janelia-modular-devices/led_controller/README.org

#+TITLE: led_controller
#+AUTHOR: Peter Polidoro
#+EMAIL: peter@polidoro.io

* Repository Information
  - Author :: Peter Polidoro
  - License :: BSD
