janelia-modular-devices/led_controller/hardware/schematic/led_controller.pdf

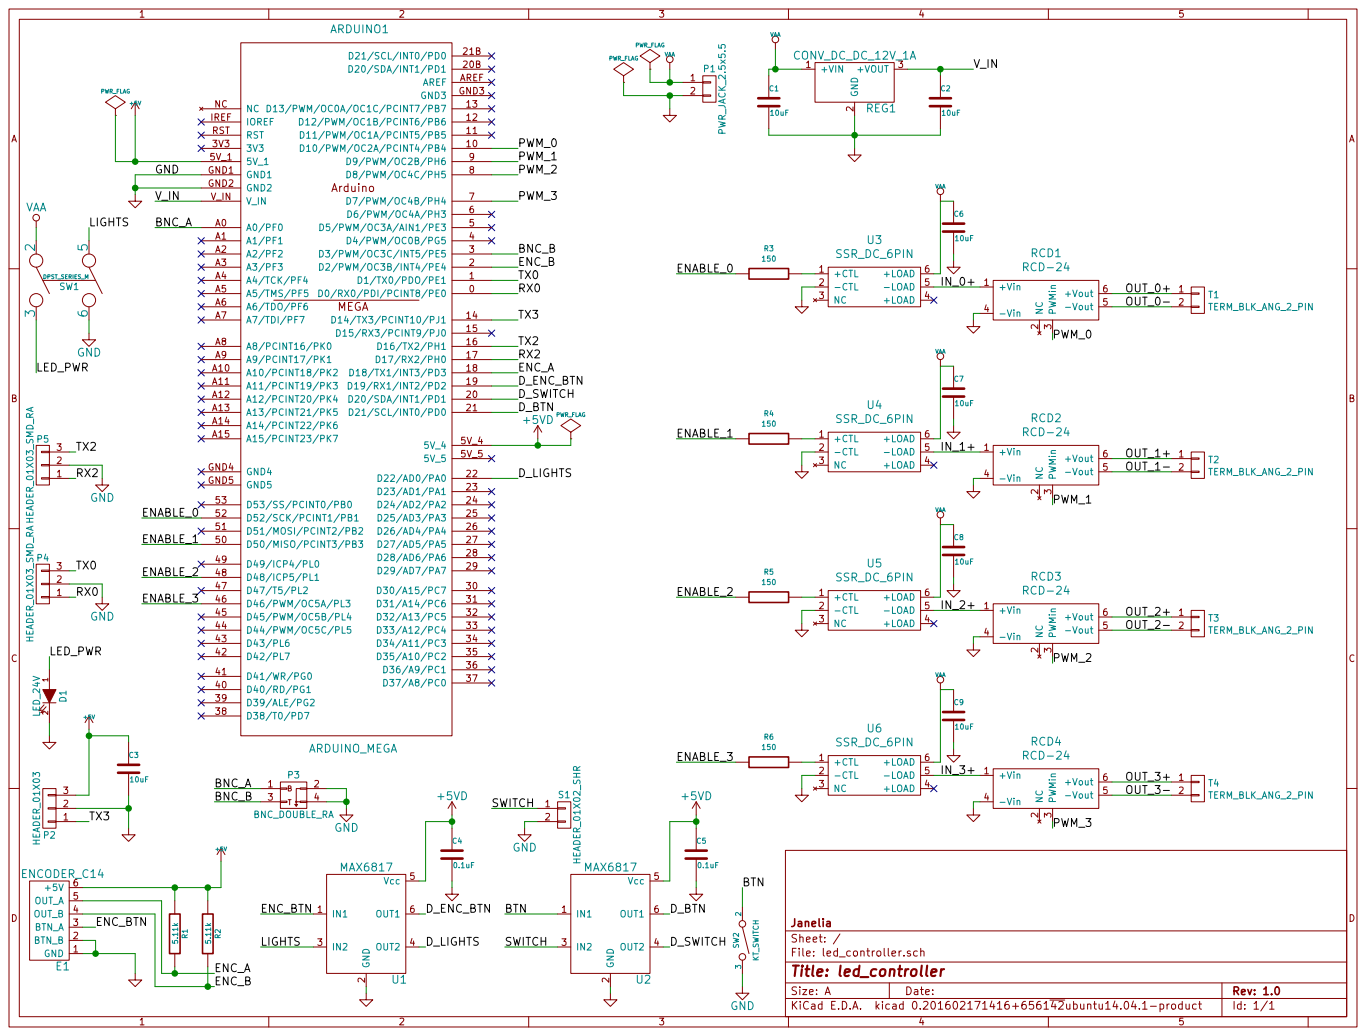
[picture p1: page 1]

File: led_controller.sch Sheet: / Janelia
