janelia-modular-devices/led_controller/(list of files, drawings)

Other design files:
hardware/led_controller.dsn
