janelia-modular-devices/led_controller/firmware/Constants.h

// ----------------------------------------------------------------------------
// Constants.h
//
//
// Authors:
// Peter Polidoro peter@polidoro.io
// ----------------------------------------------------------------------------
#ifndef CONSTANTS_H
#define CONSTANTS_H
#include "ConstantVariable.h"
#include "StandaloneInterface.h"


namespace constants
{
//MAX values must be >= 1, >= created/copied count, < RAM limit
enum{SAVED_VARIABLE_COUNT_MAX=4};
enum{PARAMETER_COUNT_MAX=16};
enum{METHOD_COUNT_MAX=20};

enum{DISPLAY_LABEL_COUNT_MAX=10};
enum{DISPLAY_VARIABLE_COUNT_MAX=1};
enum{INTERACTIVE_VARIABLE_COUNT_MAX=10};
enum {FRAME_COUNT=7};

enum {CHANNEL_COUNT=4};
enum {INDEXED_CHANNELS_POWER_COUNT_MAX=4};
enum {INDEXED_PULSES_COUNT_MAX=4};

extern const unsigned int baudrate;

extern const unsigned int model_number;

extern const unsigned char firmware_major;
extern const unsigned char firmware_minor;
extern const unsigned char firmware_patch;

extern const Standalone::Configuration standalone_configuration;

extern const int pwm_pins[CHANNEL_COUNT];
extern const int enable_pins[CHANNEL_COUNT];

extern const uint8_t power_min;
extern const uint8_t power_max;

extern const int analog_out_min;
extern const int analog_out_max;

extern const uint32_t duration_min;
extern const uint32_t duration_max;

extern const float frequency_min;
extern const float frequency_max;

extern const uint8_t duty_cycle_min;
extern const uint8_t duty_cycle_max;

extern const int delay;

extern const uint8_t dsp_lbl_display_position;
extern const uint8_t int_var_display_position;

extern const uint8_t dsp_lbl_display_position_2;
extern const uint8_t int_var_display_position_2;

extern const uint8_t inc_dsp_lbl_display_position;
extern const uint8_t inc_int_var_display_position;
extern const uint8_t chnl_dsp_lbl_display_position;
extern const uint8_t chnl_int_var_display_position;
extern const uint8_t pwr_dsp_lbl_display_position;
extern const uint8_t pwr_int_var_display_position;

extern const uint8_t period_dsp_lbl_display_position;
extern const uint8_t on_dsp_lbl_display_position;
extern const uint8_t count_dsp_lbl_display_position;

extern const uint8_t period_int_var_display_position;
extern const uint8_t on_int_var_display_position;
extern const uint8_t count_int_var_display_position;

extern const int inc_width_max;
extern const long display_period_min;
extern const long display_period_max;
extern const long display_period_default;
extern const long display_on_min;
extern const long display_on_max;
extern const long display_on_default;
extern const long display_count_min;
extern const long display_count_max;
extern const long display_count_default;
extern const long display_power_default;

extern ConstantString inc_dsp_lbl_str;
extern ConstantString chnl_dsp_lbl_str;
extern ConstantString pwr_dsp_lbl_str;

extern ConstantString period_dsp_lbl_str;
extern ConstantString on_dsp_lbl_str;
extern ConstantString count_dsp_lbl_str;

extern ConstantString device_name;

extern ConstantString duration_units_name;
extern ConstantString frequency_units_name;
extern ConstantString duty_cycle_units_name;
extern ConstantString power_units_name;

extern ConstantString channels_parameter_name;
extern ConstantString channel_parameter_name;
extern ConstantString power_parameter_name;
extern ConstantString powers_parameter_name;
extern ConstantString state_parameter_name;
extern ConstantString on_duration_parameter_name;
extern ConstantString period_parameter_name;
extern ConstantString count_parameter_name;
extern ConstantString frequency_parameter_name;
extern ConstantString duty_cycle_parameter_name;
extern ConstantString pwm_duration_parameter_name;
extern ConstantString pulse_wave_index_parameter_name;

extern ConstantString set_channel_power_method_name;
extern ConstantString set_channel_off_method_name;
extern ConstantString set_channels_powers_method_name;
extern ConstantString set_channels_off_method_name;
extern ConstantString set_all_channels_power_method_name;
extern ConstantString set_all_channels_off_method_name;
extern ConstantString get_channels_powers_method_name;
extern ConstantString get_channel_count_method_name;
extern ConstantString add_pwm_period_on_duration_method_name;
extern ConstantString add_pwm_frequency_duty_cycle_method_name;
extern ConstantString stop_all_pulses_method_name;
extern ConstantString start_pwm_period_on_duration_method_name;
extern ConstantString start_pwm_frequency_duty_cycle_method_name;
extern ConstantString stop_pulse_wave_method_name;

extern ConstantString pwm_method_name;
extern ConstantString set_pwm_defaults_method_name;
extern const ConstantString frame_name_array[FRAME_COUNT];
}
#endif
