janelia-modular-devices/led_controller/(commit log)

2016-01-29 Initial commit.
    [led_controller.dsn, led_controller.kicad_pcb, led_controller.sch]
2016-01-29 Base led_controller off aalborg_mfc_interface pcb.
    [led_controller.dsn, led_controller.kicad_pcb, led_controller.sch]
2016-01-29 Added some components.
    [led_controller.sch]
2016-02-02 Intermediate changes.
    [led_controller.sch]
2016-02-02 More progress.
    [led_controller.kicad_pcb, led_controller.sch]
2016-02-03 Laid out board.
    [led_controller.kicad_pcb]
2016-02-05 Added Header_3_Pin_SMD_RA.kicad_mod.
2016-02-05 Made changes.
    [led_controller.kicad_pcb, led_controller.sch]
2016-02-08 Added Serial2 connector.
    [led_controller.kicad_pcb, led_controller.sch]
2016-02-09 Finished pcb 1.0.
    [bom_pcb.csv, digikey_order_pcb.csv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]
2016-09-21 pcb -> hardware.
    [bom_pcb.csv, bom_pcb_add.csv, digikey_order_pcb.csv, digikey_order_pcb_add.csv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]
